fablabnbg/OpenWordClock/Wordclock_25x25_3.jpg

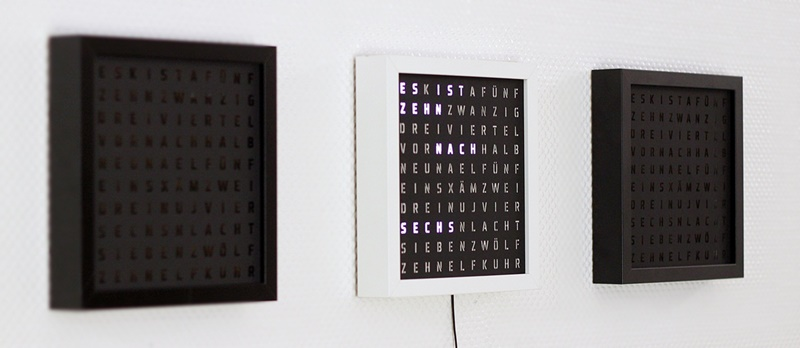
Wordclock_25x25_3.jpg
