fablabnbg/OpenWordClock/Wordclock_25x25_1.jpg

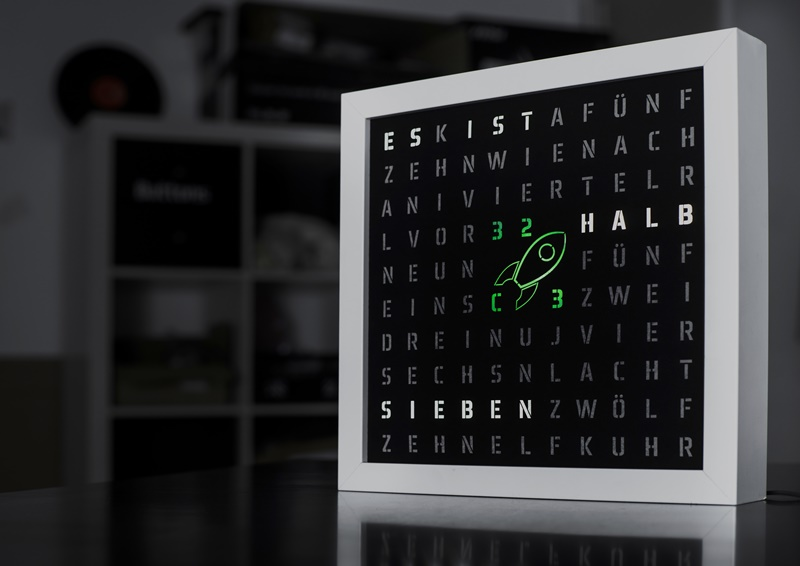
Wordclock_25x25_1.jpg
