fablabnbg/OpenWordClock/(threads)

Thread 1 (2016-01-28):

Resistors?

jnweiger, 2016-01-28:
The readme mentions appropriate resistors.
What are appropriate values?
Would it work without resistors too? Would save much work, if the controller survives.

eskaista, 2016-01-28:
150Ohm

faheus, 2016-01-28:
Depends on quantity of LEDs, on bigger clocks You might use lower resistance.

jnweiger, 2016-01-28:
I'd calculate like this:
Power supply Vcc = 5V
Voltage drop per LED Vled = 2V
Atmega328 Imax = 40mA

R = (Vcc - Vled) / Imax = (5V-2V)/0.04A = 75 ohm.

Taking Ri the internal resistance per GPIO pin into account, we only need to implement the remaining Rext for R = Ri + Rext.
The Atmega328 datasheet mentions a Voltage drop/rise of ca 1V when  draining/sourcing 20mA on a GPIO pin.
Thus Ri = 1V/0.02A = 50 ohm.

A value of Rext = R - Ri = 75 ohm - 50 ohm = 25 ohm is sufficient.
It is possible that no damage is done with Rext = 0 ohm.

jnweiger, 2016-02-06:
I understrand that often LEDs die. My assumption was that there are always enough LEDs in parallel to drain all the currrent that the controller provides. In reality, this does not work. Stick to the resistors.

Closed 2016-02-06.

Thread 9 (2017-05-30):

"ES IST" LEDs need replacement after 1.5 years?

ginkel, 2017-05-30:
The LEDs for "ES IST" on my wordclock (kit bought at 32c3) were barely recognizable anymore under normal lighting conditions as they became substantially darker over time and had to be replaced. Is this usual wear to be expected?

tuxinaut, 2019-11-30:
Good question, at least I can confirm this behavior.

Left hand side completely new clock (repaired this week), right hand side my 32c3 clock.

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

Thread 11 (2019-11-13):

Flash Anleitung

tuxinaut, 2019-11-13:
Hallo,

Ich weiß das es ein "altes" Projekt ist und vermutlich auch nicht mehr betreut aber ich versuche trotzdem mein Glück.

Ich habe hier noch eine `OpenWordClock` liegen, die nach dem anschalten nur kurz "Eins" und danach "Es ist" anzeigt. Verdrahtung und Lötstellen wurden überprüft und alles ist an seinen Platz.

Jetzt würde ich gerne die Software neu flashen, bin jetzt aber doch ein wenig überfragt wie ich was genau machen soll, im speziellen mit dem Kalibrieren muss ich das noch mal machen, wenn ja was muss ich als Externe Quellen nehmen usw.

Wäre echt super wenn sich jemand finden würde, der hier helfen kann.

tuxinaut, 2021-10-12:
:sob:

Closed 2021-10-12.
